daveho/ya68k2/(commit log)

2016-06-14 initial checkin
    [ya68k2.kicad_pcb, ya68k2.sch]
2016-06-14 added ROM chip
    [ya68k2.sch]
2016-06-15 split into multiple sheets, started CPU/glue
    [clk_reset.sch, cpu_glue_logic.sch, ya68k2.sch]
2016-06-16 some adjustments?
    [cpu_glue_logic.sch]
2016-06-16 started PLD for glue logic
2016-06-16 lots of updates, fix osc freq
    [clk_reset.sch, cpu_glue_logic.sch, ya68k2.sch]
2016-06-17 redesigned reset circuit to use MAX708
    This avoids the need to generate pulses for the
    watchdog timer, which we don't want or need.
    Also, eliminated the '393 counter to divide the
    clock, since A19 (which will go high the first time
    the code jumps to an address at 80000 or above)
    can serve as the trigger to disable the ROM
    aliasing.
    The fewer chips, the better!
    [clk_reset.sch, cpu_glue_logic.sch, ya68k2.sch]
2016-06-17 something changed?
    [clk_reset.sch]
2016-06-17 updates to fix kicad 3/4 version mismatches
    [clk_reset.sch, cpu_glue_logic.sch]
2016-06-17 fix VCC symbols
    [clk_reset.sch, cpu_glue_logic.sch]
2016-06-18 removed - we'll use our own device library
2016-06-18 remove reference to devices-sergey.lib
2016-06-18 working on glue logic, chip selects
    [clk_reset.sch, cpu_glue_logic.sch, ya68k2.sch]
2016-06-18 added flash ROM device
    [clk_reset.sch, cpu_glue_logic.sch, memory.sch, ya68k2.sch]
2016-06-18 added '574 output port, decoupling caps
    [clk_reset.sch, cpu_glue_logic.sch, iodev.sch, memory.sch, ya68k2.sch]
2016-06-18 number the resistors
    [clk_reset.sch, cpu_glue_logic.sch, memory.sch]
2016-06-19 replace '574 with '374
    The '574 is hard to find and expensive as a 74LS part.
    [iodev.sch]
2016-06-19 put 10k pull ups on data bus
    idea from 68Katy, http://www.bigmessowires.com/68-katy/
    [cpu_glue_logic.sch]
2016-06-19 invert R/-W to feed to -OE of I/O devices
    another idea stolen from 68Katy
    [cpu_glue_logic.sch, iodev.sch, memory.sch]
2016-06-19 hard-wire -VPA to VCC
    The signal is not (and probably never will be)
    generated by the glue logic, and we don't want
    to leave any inputs floating.
    [cpu_glue_logic.sch, memory.sch]
2016-06-19 feed CLK to CPU clock pin, not CLKDIV2
    we actually don't have a CLKDIV2 signal any more,
    now that the clock/reset circuit no longer uses
    the '393 counter as a clock divider
    [cpu_glue_logic.sch]
2016-06-19 move schematics/PLD into "hw" subdirectory
    [clk_reset.sch, cpu_glue_logic.sch, iodev.sch, memory.sch, ya68k2.kicad_pcb, ya68k2.sch]
2016-06-20 attempt at LED blink program, untested
2016-06-21 fix bad "-NDEVOE" global label (should be -DEVOE)
    Also added power LED, screw terminal for power
    connection, and 8 pin header for output port.
    [clk_reset.sch, cpu_glue_logic.sch, iodev.sch, memory.sch, ya68k2.sch]
2016-06-21 fix: tie -BERR to VCC via resistor
    also, use a resistor network rather than discrete
    resistors for tying misc. CPU inputs to VCC
    [cpu_glue_logic.sch]
2016-07-01 start program to test glue logic
    just blinks LEDs for now
2016-07-01 pin assignments
2016-07-02 started to implement tests
    the -DEVOE test is failing, need to investigate...
    [gluetest.c]
2016-07-02 fix bug in control_out(), test_ndevoe passes now
    issue was that we were updating control signals using
    PORTD |= stuff;
    which cannot ever turn a 1 bit back to 0. Correct
    invocation is
    PORTD = stuff;
    [gluetest.c]
2016-07-04 add test for -ROMEN (failing currently)
    also, use LEDs to blink failed test/assert num.
    [gluetest.c]
2016-07-05 some cleanup of LED blinking code
2016-07-05 use comment to describe wiring of indicator LEDs
2016-07-05 added test for -OPORTEN signal
    At this point all of the tests are passing, so
    it would seem that the glue logic PLD is working
    correctly!
    [gluetest.c]
2016-07-09 don't use C preprocessor, use .equ for constants
    For some reason, constants don't assemble correctly
    (possibly because the C preprocessor won't expand
    them when prefixed with #.) So, just use a '.s'
    file, and use .equ to define constants.
    Disassembly does seem to look reasonable now.
2016-07-12 reduce timing delay
    with the oscillator running at 3.6864 Mhz, this makes
    it more noticeable that the LEDs are doing something
2016-07-15 glue logic: remap ROM to high 512K on boot
    Started to update test circuit and test program:
    the BOOTED register does appear to be working
    correctly.
    Need to update the circuit and test program to be able
    to generate additional control signals (9 in total, since
    we need A16..A19, not just A19).
    [gluetest.c]
2016-07-15 simplified test and assertion macros
    Avoid requiring explicit variables for control
    and signal values
    [gluetest.c]
2016-07-15 verify that ROM is mapped low again after reset
    [gluetest.c]
2016-07-15 use 16 bit type for control signals
    There are now 9 control signals (including address lines)
    that are significant to the glue logic.
2016-07-16 add README.md describing glue logic test
2016-07-17 picture of glue test circuit
2021-11-09 Update README.md
    https://forum.kicad.info/t/warning-avoid-all-links-to-kicad-pcb-org-use-kicad-org/31521
